SerhiiMazurBeetroot/emb-wireless_sensor_network/docs/images/gateway.jpg

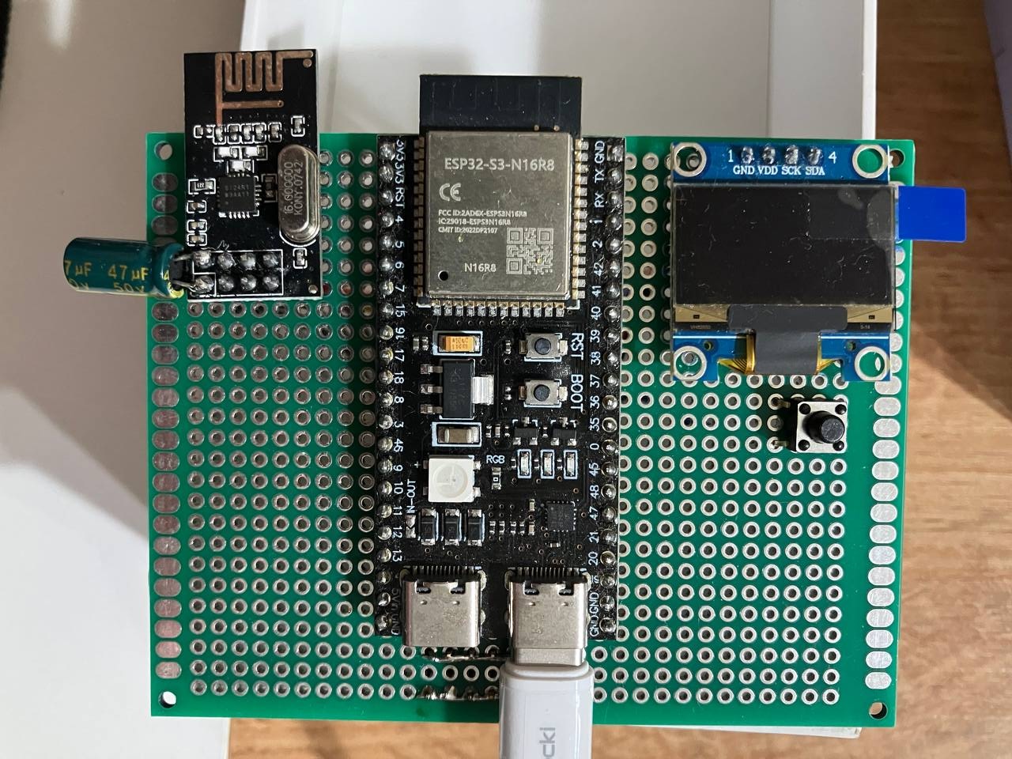
docs/images/gateway.jpg
