SerhiiMazurBeetroot/emb-wireless_sensor_network/docs/images/nodes.jpg

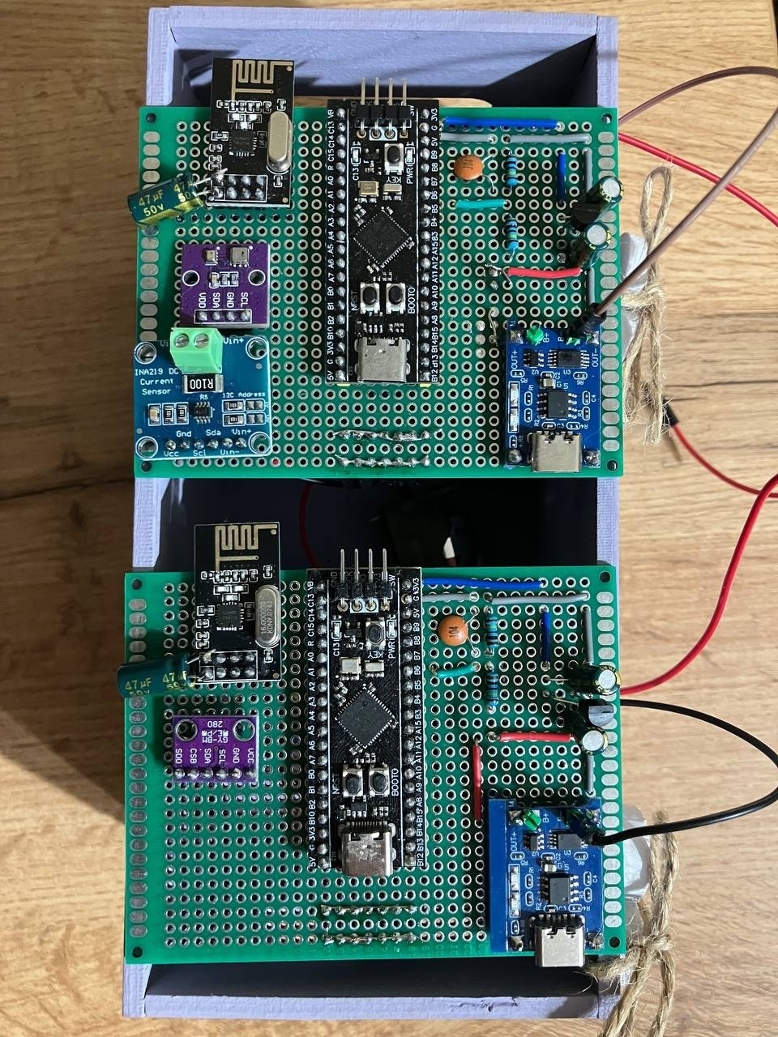
docs/images/nodes.jpg
