SerhiiMazurBeetroot/emb-wireless_sensor_network/gateway/assets/step_1/5381909032429363157.jpg

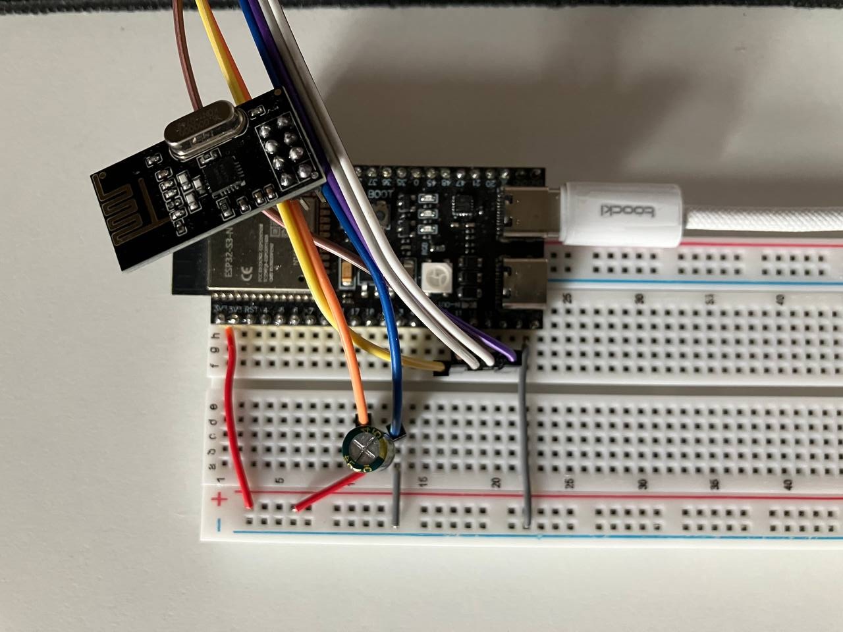
gateway/assets/step_1/5381909032429363157.jpg
