SerhiiMazurBeetroot/emb-wireless_sensor_network/gateway/assets/step_1/SCR-20261019-kwpb.png

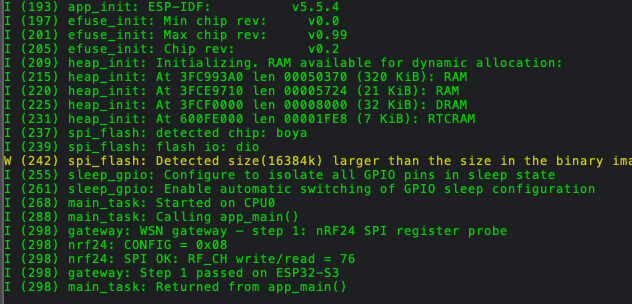
gateway/assets/step_1/SCR-20261019-kwpb.png
