SerhiiMazurBeetroot/emb-wireless_sensor_network/gateway/assets/step_5/logs.png

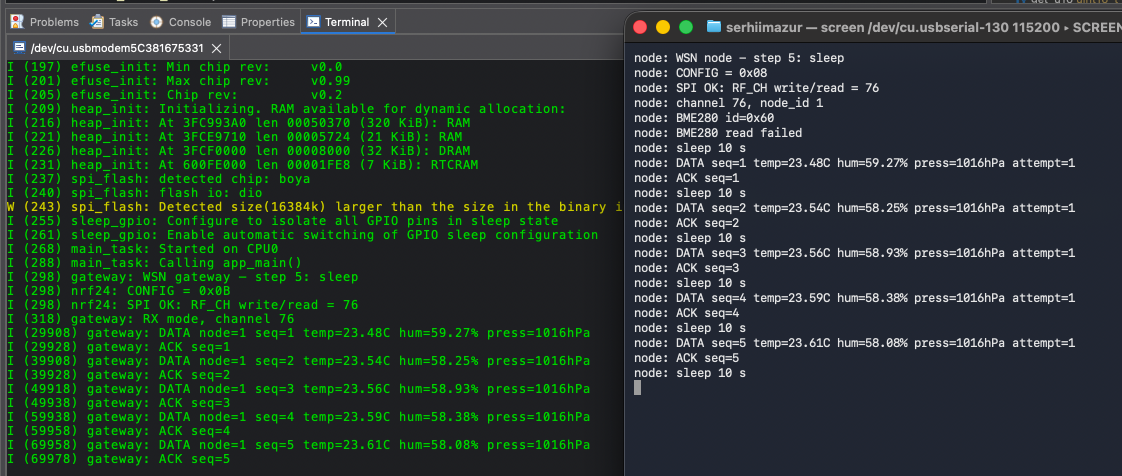
gateway/assets/step_5/logs.png
