SerhiiMazurBeetroot/emb-wireless_sensor_network/gateway/assets/step_9/board.jpg

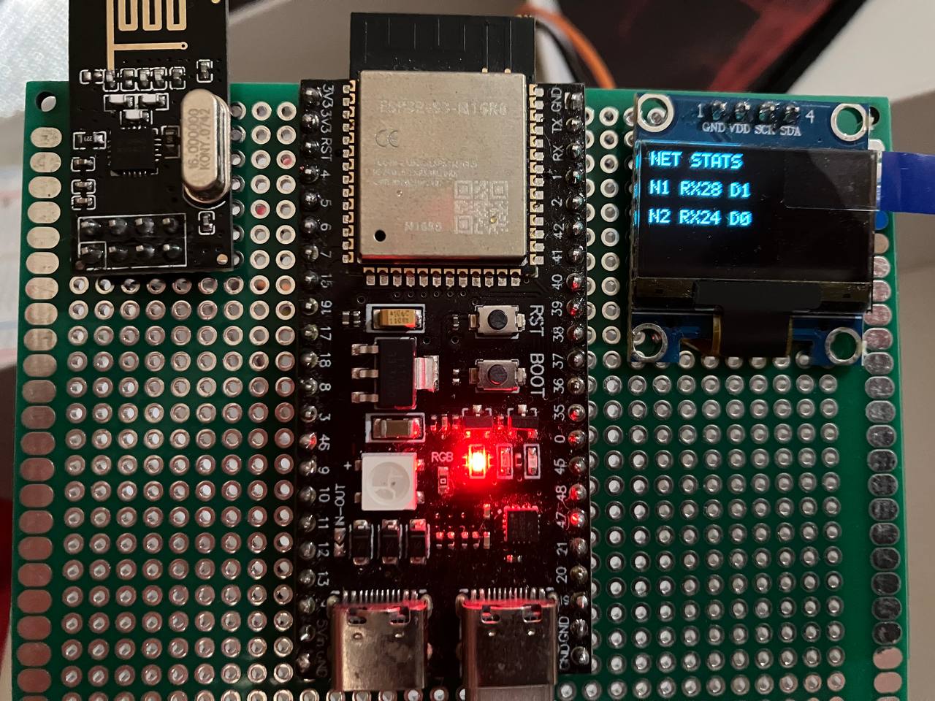
gateway/assets/step_9/board.jpg
