SerhiiMazurBeetroot/emb-wireless_sensor_network/node/assets/step_1/5381909032429363156.jpg

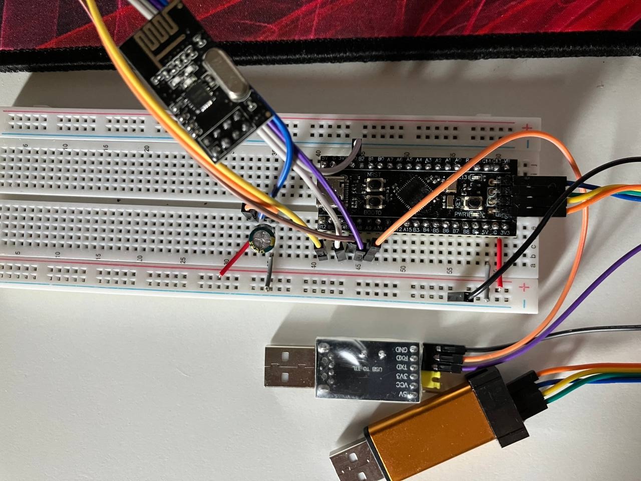
node/assets/step_1/5381909032429363156.jpg
