SerhiiMazurBeetroot/emb-wireless_sensor_network/node/assets/step_2/SCR-20261019-msvh.png

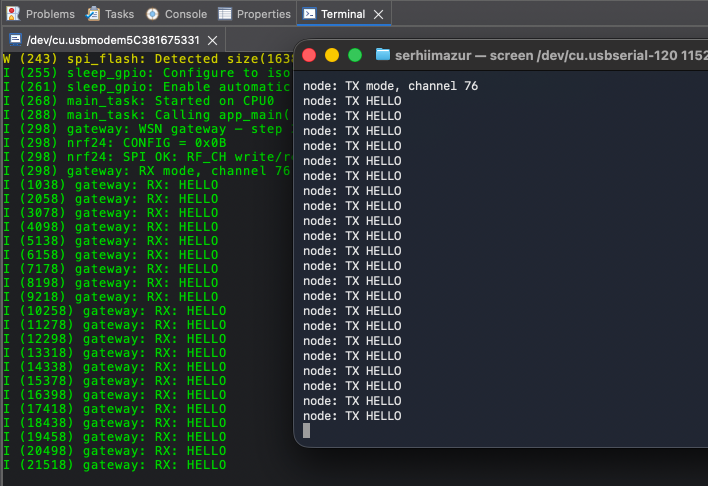
node/assets/step_2/SCR-20261019-msvh.png
