SerhiiMazurBeetroot/emb-wireless_sensor_network/node/assets/step_3/IMG_2554.gif

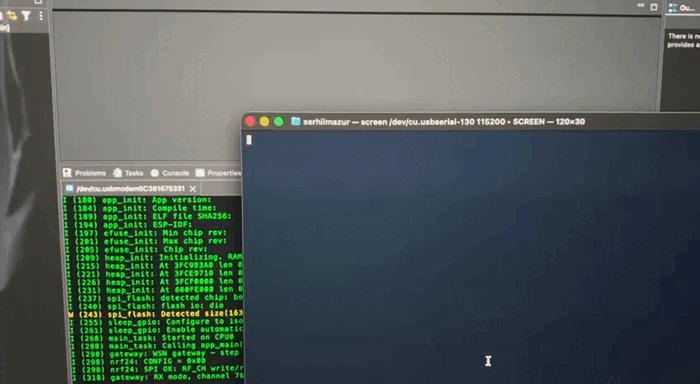
node/assets/step_3/IMG_2554.gif
