SerhiiMazurBeetroot/emb-wireless_sensor_network/node/assets/step_4/logs.png

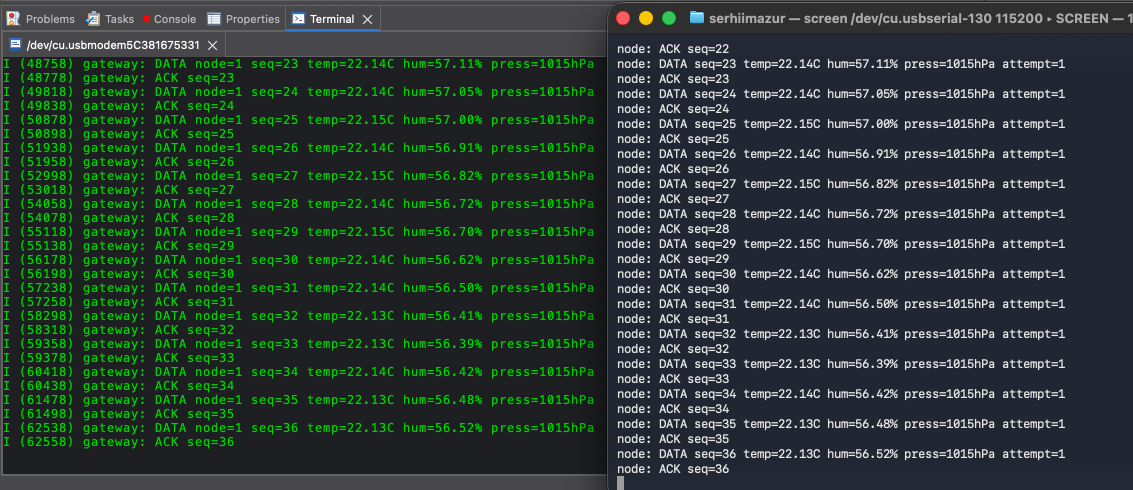
node/assets/step_4/logs.png
