SerhiiMazurBeetroot/emb-wireless_sensor_network/node/assets/step_5/logs_attempts.png

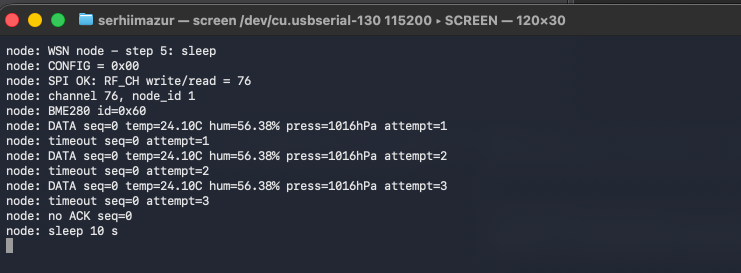
node/assets/step_5/logs_attempts.png
