SerhiiMazurBeetroot/emb-wireless_sensor_network/node/assets/step_6/logs.png

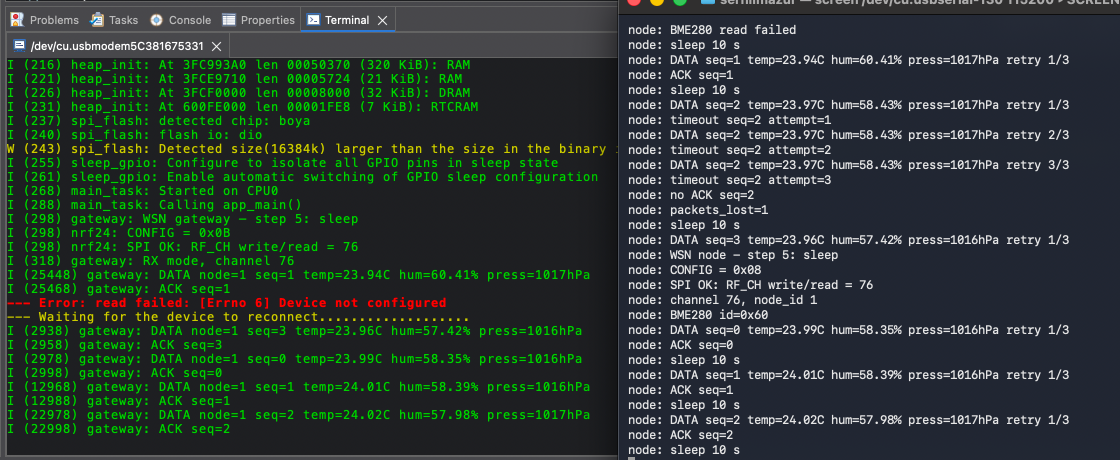
node/assets/step_6/logs.png
