SerhiiMazurBeetroot/emb-wireless_sensor_network/node/assets/step_11/board.jpg

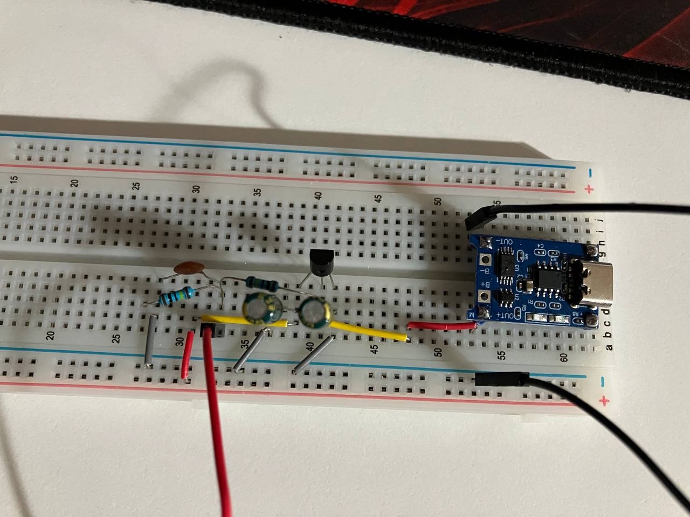
node/assets/step_11/board.jpg
