SerhiiMazurBeetroot/emb-wireless_sensor_network/node/Drivers/nrf24/nrf24.c

#include "nrf24.h"
#include "main.h"

#include <stdio.h>
#include <string.h>

extern SPI_HandleTypeDef hspi2;
extern UART_HandleTypeDef huart1;

/* CSN = 1: the radio is deselected and the SPI transaction is closed. */
static void csn_high(void)
{
    HAL_GPIO_WritePin(GPIOB, GPIO_PIN_12, GPIO_PIN_SET);
}

/* CSN = 0: start an SPI transaction with the nRF24. */
static void csn_low(void)
{
    HAL_GPIO_WritePin(GPIOB, GPIO_PIN_12, GPIO_PIN_RESET);
}

/* CE = 0: reception is stopped and no transmit pulse is issued. */
static void ce_low(void)
{
    HAL_GPIO_WritePin(GPIOA, GPIO_PIN_8, GPIO_PIN_RESET);
}

/* CE = 1: enables reception in RX mode; a short pulse starts a transmission in TX mode. */
static void ce_high(void)
{
	HAL_GPIO_WritePin(GPIOA, GPIO_PIN_8, GPIO_PIN_SET);
}

static const uint8_t s_addr[NRF24_ADDR_WIDTH] = {0xA5, 0xA5, 0xA5, 0xA5, 0xA5};

/* Exchange len bytes over SPI: tx goes to the radio, rx collects the reply. */
static void spi_transfer(uint8_t *tx, uint8_t *rx, uint16_t len)
{
    HAL_SPI_TransmitReceive(&hspi2, tx, rx, len, 10);
}

static void log_msg(const char *text)
{
    const char prefix[] = "node: ";

    HAL_UART_Transmit(&huart1, (uint8_t *)prefix, sizeof(prefix) - 1, 100);
    HAL_UART_Transmit(&huart1, (uint8_t *)text, strlen(text), 100);
}

/* Configure CE and CSN as outputs and bring up the SPI2 bus. The radio stays off. */
void nrf24_init(void)
{
    GPIO_InitTypeDef gpio = {0};

    gpio.Mode = GPIO_MODE_OUTPUT_PP;
    gpio.Pull = GPIO_NOPULL;
    gpio.Speed = GPIO_SPEED_FREQ_LOW;

    gpio.Pin = GPIO_PIN_12;
    HAL_GPIO_Init(GPIOB, &gpio);

    gpio.Pin = GPIO_PIN_8;
    HAL_GPIO_Init(GPIOA, &gpio);

    csn_high();
    ce_low();
}

/* Read a register. The first reply byte is STATUS; the register value is the second byte. */
uint8_t nrf24_read_reg(uint8_t reg)
{
    uint8_t tx[2] = {(uint8_t)(NRF24_SPI_CMD_R_REGISTER | (reg & 0x1F)), 0x00};
    uint8_t rx[2] = {0};

    csn_low();
    spi_transfer(tx, rx, sizeof(tx));
    csn_high();

    return rx[1];
}

/* Write one byte to a register with the W_REGISTER command. */
void nrf24_write_reg(uint8_t reg, uint8_t value)
{
    uint8_t tx[2] = {(uint8_t)(NRF24_SPI_CMD_W_REGISTER | (reg & 0x1F)), value};
    uint8_t rx[2] = {0};

    csn_low();
    spi_transfer(tx, rx, sizeof(tx));
    csn_high();
}

/* Check that the radio is on the bus: write RF_CH and read the same value back. */
bool nrf24_spi_probe(void)
{
    char buf[64];
    const uint8_t config_before = nrf24_read_reg(NRF24_REG_CONFIG);

    snprintf(buf, sizeof(buf), "CONFIG = 0x%02X\r\n", config_before);
    log_msg(buf);

    nrf24_write_reg(NRF24_REG_RF_CH, NRF24_RF_CHANNEL);
    const uint8_t channel = nrf24_read_reg(NRF24_REG_RF_CH);
    const bool ok = (channel == NRF24_RF_CHANNEL);

    if (ok) {
        snprintf(buf, sizeof(buf), "SPI OK: RF_CH write/read = %u\r\n", channel);
    } else {
        snprintf(buf, sizeof(buf), "SPI FAIL: expected RF_CH %u, got 0x%02X\r\n",
                 NRF24_RF_CHANNEL, channel);
    }
    log_msg(buf);

    return ok;
}

/* Write several bytes to a register. Used to set the RX and TX address. */
static void write_buf(uint8_t reg, const uint8_t *data, uint8_t len) {
	uint8_t tx[1 + 32] = {0};
	uint8_t rx[1 + 32] = {0};

	tx[0] = (uint8_t)(NRF24_SPI_CMD_W_REGISTER | (reg & 0x1F));
	memcpy(&tx[1], data, len);

	csn_low();
	spi_transfer(tx, rx, (uint16_t)len + 1);
	csn_high();
}

/* Run a command with no data payload: FLUSH_TX or FLUSH_RX. */
static void command(uint8_t cmd) {
	uint8_t tx = cmd;
	uint8_t rx = 0;
	csn_low();
	spi_transfer(&tx, &rx, 1);
	csn_high();
}

/* Load a packet into the TX FIFO with the W_TX_PAYLOAD command. */
static void write_payload(const uint8_t *data, uint8_t len) {
	uint8_t tx[1 + 32] = {0};
	uint8_t rx[1 + 32] = {0};

	tx[0] = NRF24_CMD_W_TX_PAYLOAD;
	memcpy(&tx[1], data, len);

	csn_low();
	spi_transfer(tx, rx, (uint16_t)len + 1);
	csn_high();
}

/* Read a packet from the RX FIFO. The first reply byte is discarded; the payload follows. */
static void read_payload(uint8_t *data, uint8_t len) {
	uint8_t tx[1 + 32] = {0};
	uint8_t rx[1 + 32] = {0};

	tx[0] = NRF24_CMD_R_RX_PAYLOAD;

	csn_low();
	spi_transfer(tx, rx, (uint16_t)len + 1);
	csn_high();

	memcpy(data, &rx[1], len);
}

/* Disable auto-ack and set channel 76, 1 Mbps, 0 dBm, a 5-byte address, and 1-byte CRC. */
void nrf24_radio_init(void) {
	ce_low();
	nrf24_write_reg(NRF24_REG_CONFIG, NRF24_CONFIG_EN_CRC);
	nrf24_write_reg(NRF24_REG_EN_AA, 0x00);
	nrf24_write_reg(NRF24_REG_EN_RXADDR, 0x01);
	nrf24_write_reg(NRF24_REG_SETUP_AW, 0x03);
	nrf24_write_reg(NRF24_REG_SETUP_RETR, 0x00);
	nrf24_write_reg(NRF24_REG_RF_CH, NRF24_RF_CHANNEL);
	nrf24_write_reg(NRF24_REG_RF_SETUP, 0x06);
	write_buf(NRF24_REG_RX_ADDR_P0, s_addr, NRF24_ADDR_WIDTH);
	write_buf(NRF24_REG_TX_ADDR, s_addr, NRF24_ADDR_WIDTH);
	nrf24_write_reg(NRF24_REG_RX_PW_P0, NRF24_PAYLOAD_LEN);
	command(NRF24_CMD_FLUSH_TX);
	command(NRF24_CMD_FLUSH_RX);
	nrf24_write_reg(NRF24_REG_STATUS, NRF24_STATUS_RX_DR | NRF24_STATUS_TX_DS | NRF24_STATUS_MAX_RT);
	nrf24_write_reg(NRF24_REG_CONFIG, NRF24_CONFIG_EN_CRC | NRF24_CONFIG_PWR_UP);
	HAL_Delay(2);
}

/* Drop CE and clear PWR_UP. The radio enters power-down. */
void nrf24_power_down(void) {
	ce_low();
	nrf24_write_reg(NRF24_REG_CONFIG, NRF24_CONFIG_EN_CRC);
}

/* Set PRIM_RX, wait for the standby exit, then raise CE to listen on the air. */
void nrf24_set_rx_mode(void){
	ce_low();
	nrf24_write_reg(NRF24_REG_CONFIG, NRF24_CONFIG_EN_CRC | NRF24_CONFIG_PWR_UP | NRF24_CONFIG_PRIM_RX);
//	HAL_Delay(2);
	/* ~200 us: RX settling is 130 us. HAL_Delay(2) misses the ACK. */
	for (volatile uint32_t i = 0; i < (SystemCoreClock / 1000000U) * 50U; i++) {
		__NOP();
	}
	ce_high();
}

/* Clear PRIM_RX and wait 2 ms. Transmission starts later with a separate CE pulse. */
void nrf24_set_tx_mode(void) {
	ce_low();
	nrf24_write_reg(NRF24_REG_CONFIG, NRF24_CONFIG_EN_CRC | NRF24_CONFIG_PWR_UP);
	HAL_Delay(2);
}

/* Send one NRF24_PAYLOAD_LEN frame and wait for TX_DS. False when the radio sets MAX_RT or the wait times out. */
bool nrf24_send(const uint8_t *data, uint8_t len) {
	uint32_t start;

	if (len != NRF24_PAYLOAD_LEN) {
		return false;
	}

	nrf24_set_tx_mode();
	write_payload(data, len);
	ce_high();
	for (volatile uint32_t i = 0; i < (SystemCoreClock / 1000000U) * 5U; i++) {
		__NOP();
	}
	ce_low();

	start = HAL_GetTick();
	while ((HAL_GetTick() - start) < 10U) {
		const uint8_t status = nrf24_read_reg(NRF24_REG_STATUS);
		if (status & NRF24_STATUS_TX_DS) {
			nrf24_write_reg(NRF24_REG_STATUS, NRF24_STATUS_TX_DS);
			return true;
		}
		if (status & NRF24_STATUS_MAX_RT) {
			command(NRF24_CMD_FLUSH_TX);
			nrf24_write_reg(NRF24_REG_STATUS, NRF24_STATUS_MAX_RT);
			return false;
		}
	}

	return false;
}

void nrf24_flush_rx(void)
{
	command(NRF24_CMD_FLUSH_RX);
	nrf24_write_reg(NRF24_REG_STATUS, NRF24_STATUS_RX_DR);
}

/* Read one packet when RX_DR is set or the RX FIFO is not empty. */
bool nrf24_receive(uint8_t *data, uint8_t len) {
	if (len != NRF24_PAYLOAD_LEN) {
		return false;
	}

	const uint8_t status = nrf24_read_reg(NRF24_REG_STATUS);
	const uint8_t fifo = nrf24_read_reg(NRF24_REG_FIFO_STATUS);
	if ((status & NRF24_STATUS_RX_DR) == 0 &&
		(fifo & NRF24_FIFO_RX_EMPTY) != 0) {
		return false;
	}

	read_payload(data, len);
	nrf24_write_reg(NRF24_REG_STATUS, NRF24_STATUS_RX_DR);
	return true;
}
