SerhiiMazurBeetroot/emb-wireless_sensor_network/(commit log)

2026-10-04 ADD | init node (stm32) DIR
2026-10-15 ADD | step 1 | gateway | nRF24 SPI register probe
2026-10-15 ADD | step 1 | node | nRF24 SPI register probe
2026-10-20 ADD | step 4 | gateway | BME280 sensor payload
2026-10-20 ADD | step 4 | node | BME280 sensor payload
2026-10-25 ADD | step 9 | gateway | multi-node filter and per-node stats
2026-10-25 ADD | step 10 | gateway | network and error counters
    [main.c]
2026-10-28 ADD | step 11 | node | battery voltage on PA1
2026-10-30 ADD | gateway | button component to toggles the OLED between the node and statistics
2026-10-30 UPDATE | gateway | nrf24 fast RX/TX switch, IRQ masks, RX poll timeout, ACK turnaround
2026-10-30 UPDATE | gateway | ssd1306 redesign OLED on u8g2: one node per screen, link stats table
    [main.c]
2026-10-31 ADD | node | INA219 driver and sleep mode from the ACK
2026-11-01 ADD | gateway | web page, mode buttons, charts and CSV
